septillion-git/RetroTL/KiCAD/RetroTL.kicad_pcb

## KiCad design KiCAD/RetroTL.kicad_pcb (2016-09-09)

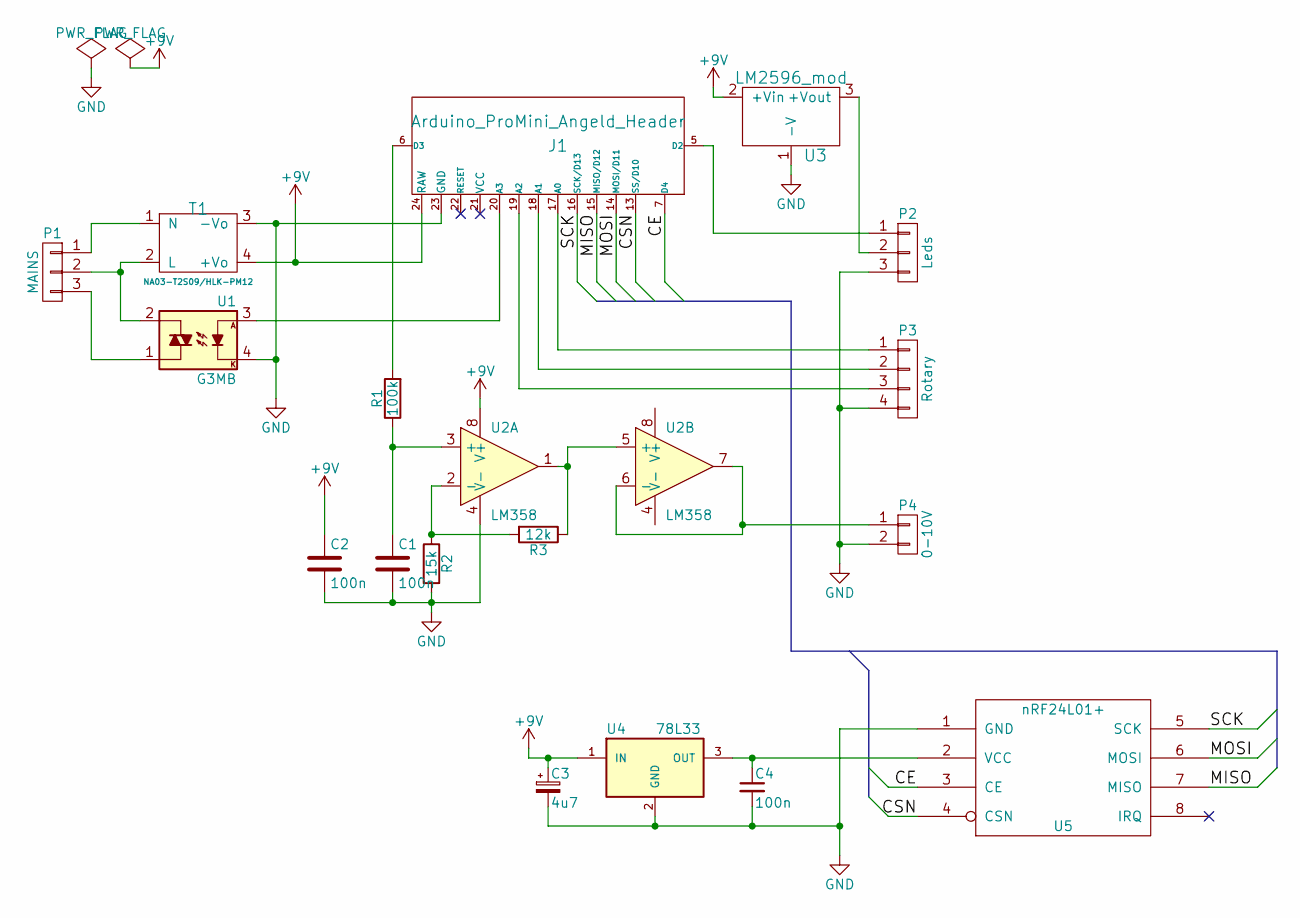
[picture p1: schematic RetroTL.sch, RetroTl Dimmer]

Parts:
C1, C2, C4: 100n; C_0805_HandSoldering
C3: 4u7; C_Radial_D5_L6_P2.5
J1: Arduino_ProMini_Angeld_Header; Arduino_ProMini_Angeled_Small++
P1: MAINS; bornier3
P2: Leds; pin_strip_3
P3: Rotary; pin_strip_4
P4: 0-10V; pin_strip_2
R1: 100k; R_0805_HandSoldering
R2: 15k; R_0805_HandSoldering
R3: 12k; R_0805_HandSoldering
T1: NA03-T2S09/HLK-PM12; Universal_NA03-T2Sxx_HLK-PMxx
U1: G3MB; G3MB-xxxx
U2: LM358; SOIC-8-N
U3: LM2596_mod; MP2307_module_3pin
U4: 78L33; TO-92_Inline_Narrow_Oval
U5: nRF24L01+; NRF24L01_MODULE

Connections:
+9V: C2.1, C3.1, J1.24 (RAW), T1.4 (+Vo), U2.8 (V+), U3.2 (+Vin), U4.1 (IN)
/CE: J1.7 (D4), U5.3 (CE)
/CSN: J1.13 (SS/D10), U5.4 (CSN)
/MISO: J1.15 (MISO/D12), U5.7 (MISO)
/MOSI: J1.14 (MOSI/D11), U5.6 (MOSI)
/SCK: J1.16 (SCK/D13), U5.5 (SCK)
GND: C1.2, C2.2, C3.2, C4.2, J1.23 (GND), P2.3, P3.4, P4.2, R2.2, T1.3 (-Vo), U1.4, U2.4 (V-), U3.1 (-V), U4.2 (GND), U5.1 (GND)
unnamed: C1.1, R1.1, U2.3 (+)
unnamed: C4.1, U4.3 (OUT), U5.2 (VCC)
unnamed: J1.5 (D2), P2.1
unnamed: J1.6 (D3), R1.2
unnamed: J1.17 (A0), P3.1
unnamed: J1.18 (A1), P3.2
unnamed: J1.19 (A2), P3.3
unnamed: J1.20 (A3), U1.3
unnamed: P1.1, T1.1 (N)
unnamed: P1.2, T1.2 (L), U1.2
unnamed: P1.3, U1.1
unnamed: P2.2, U3.3 (+Vout)
unnamed: P4.1, U2.6 (-), U2.7
unnamed: R2.1, R3.2, U2.2 (-)
unnamed: R3.1, U2.1, U2.5 (+)

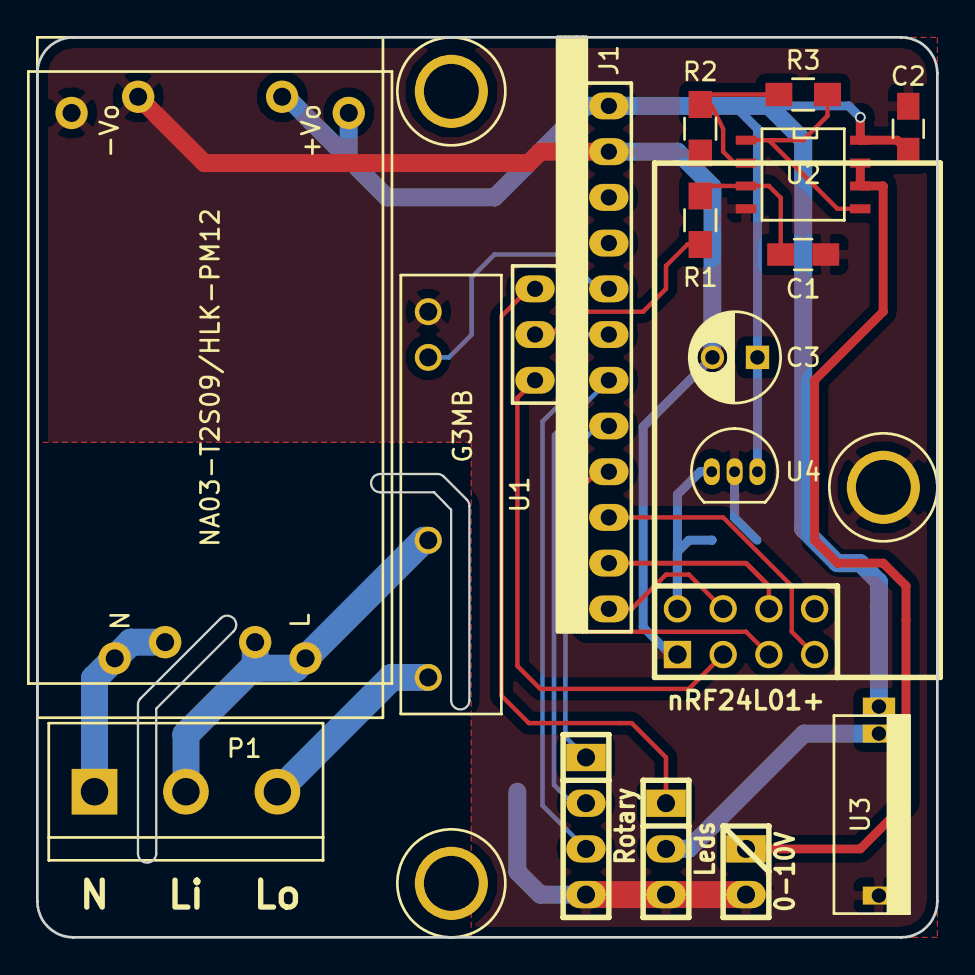
[picture p2: board RetroTL.kicad_pcb from above]

Board: 2 copper layers, 50.0 x 50.0 mm, 18 parts (1 on the bottom side), 22 nets.
