septillion-git/RetroTL/(commit log)

2016-09-05 First publish
    incl PCB based on RF433
    [RetroTL - Copy.kicad_pcb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]
2016-09-05 Schematic change to RF34L01
    [RetroTL.sch]
2016-09-08 PCB with NRF24N01
    [RetroTL-B.Cu.gbr, RetroTL-B.Mask.gbr, RetroTL-B.SilkS.gbr, RetroTL-Edge.Cuts.gbr, RetroTL-F.Cu.gbr, RetroTL-F.Mask.gbr, RetroTL-F.SilkS.gbr, RetroTL.drl]
2016-09-08 Small fixes
    [RetroTL-B.Cu.gbr, RetroTL-B.Mask.gbr, RetroTL-B.SilkS.gbr, RetroTL-Edge.Cuts.gbr, RetroTL-F.Cu.gbr, RetroTL-F.Mask.gbr, RetroTL-F.SilkS.gbr, RetroTL.drl]
2016-09-08 Added DirtyPCBs Gerbers
    [RetroTL-B.Cu.gbl, RetroTL-B.Mask.gbs, RetroTL-B.SilkS.gbo, RetroTL-Edge.Cuts.gbr, RetroTL-Edge.Cuts.gm1, RetroTL-F.Cu.gtl, RetroTL-F.Mask.gts, RetroTL-F.SilkS.gto]
2016-09-09 Added some schematic values
    [RetroTL.kicad_pcb, RetroTL.sch, _saved_RetroTL.sch]
